jasoncardinale/Chess-Clock/(commit log)

2026-09-01 bom table
2026-09-02 Pulse led on game over
2026-09-02 reverse led pulse
2026-09-05 update bom
2026-09-07 add schematic
